GROchet/GROchet_PCB/TopViewAnotated.png

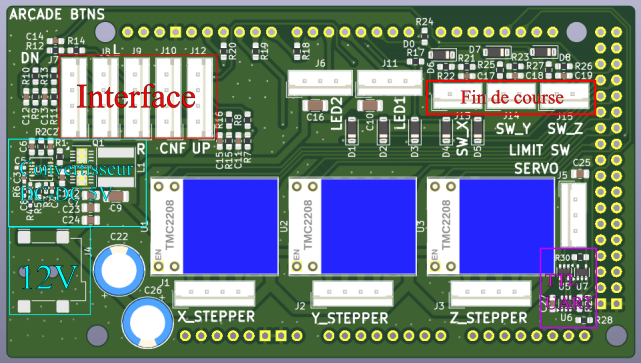
TopViewAnotated.png
