GROchet/GROchet_PCB/GROchet_Bloc_Diagram.drawio.png

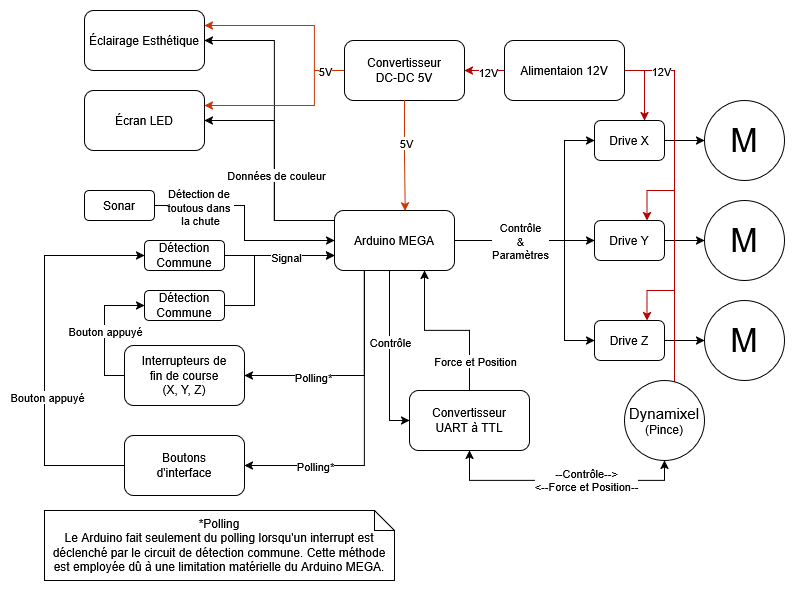
GROchet_Bloc_Diagram.drawio.png
