GROchet/GROchet_PCB/WBSchematicTPS40305DRCR.png

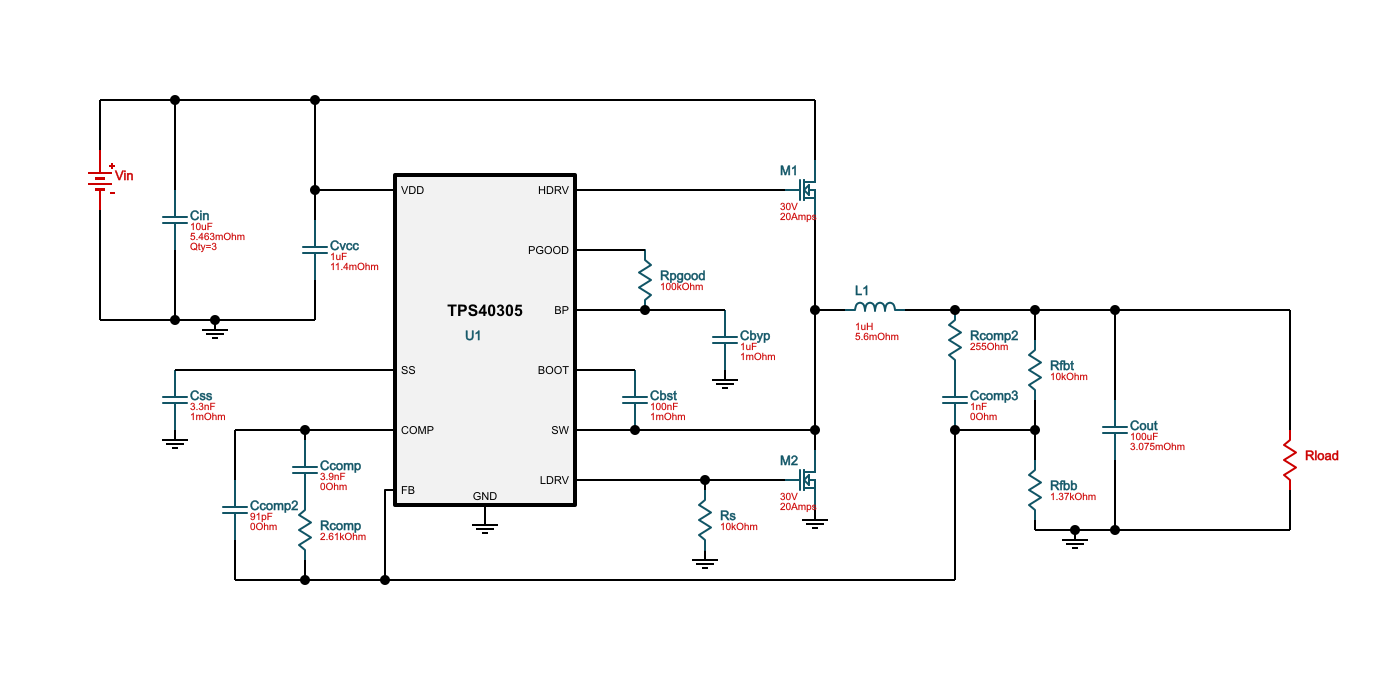
WBSchematicTPS40305DRCR.png
