GROchet/GROchet_PCB/LTSpice/Button_Debounce.asc

C1: cap; 1µ
R1: res; 10000
R2: res; 1000
V1: voltage; 5
Named nets: 0
.ic N002 = 5
