GROchet/GROchet_PCB/GROchet_PCB.kicad_pcb

## KiCad design GROchet_PCB.kicad_pcb (2026-02-21)

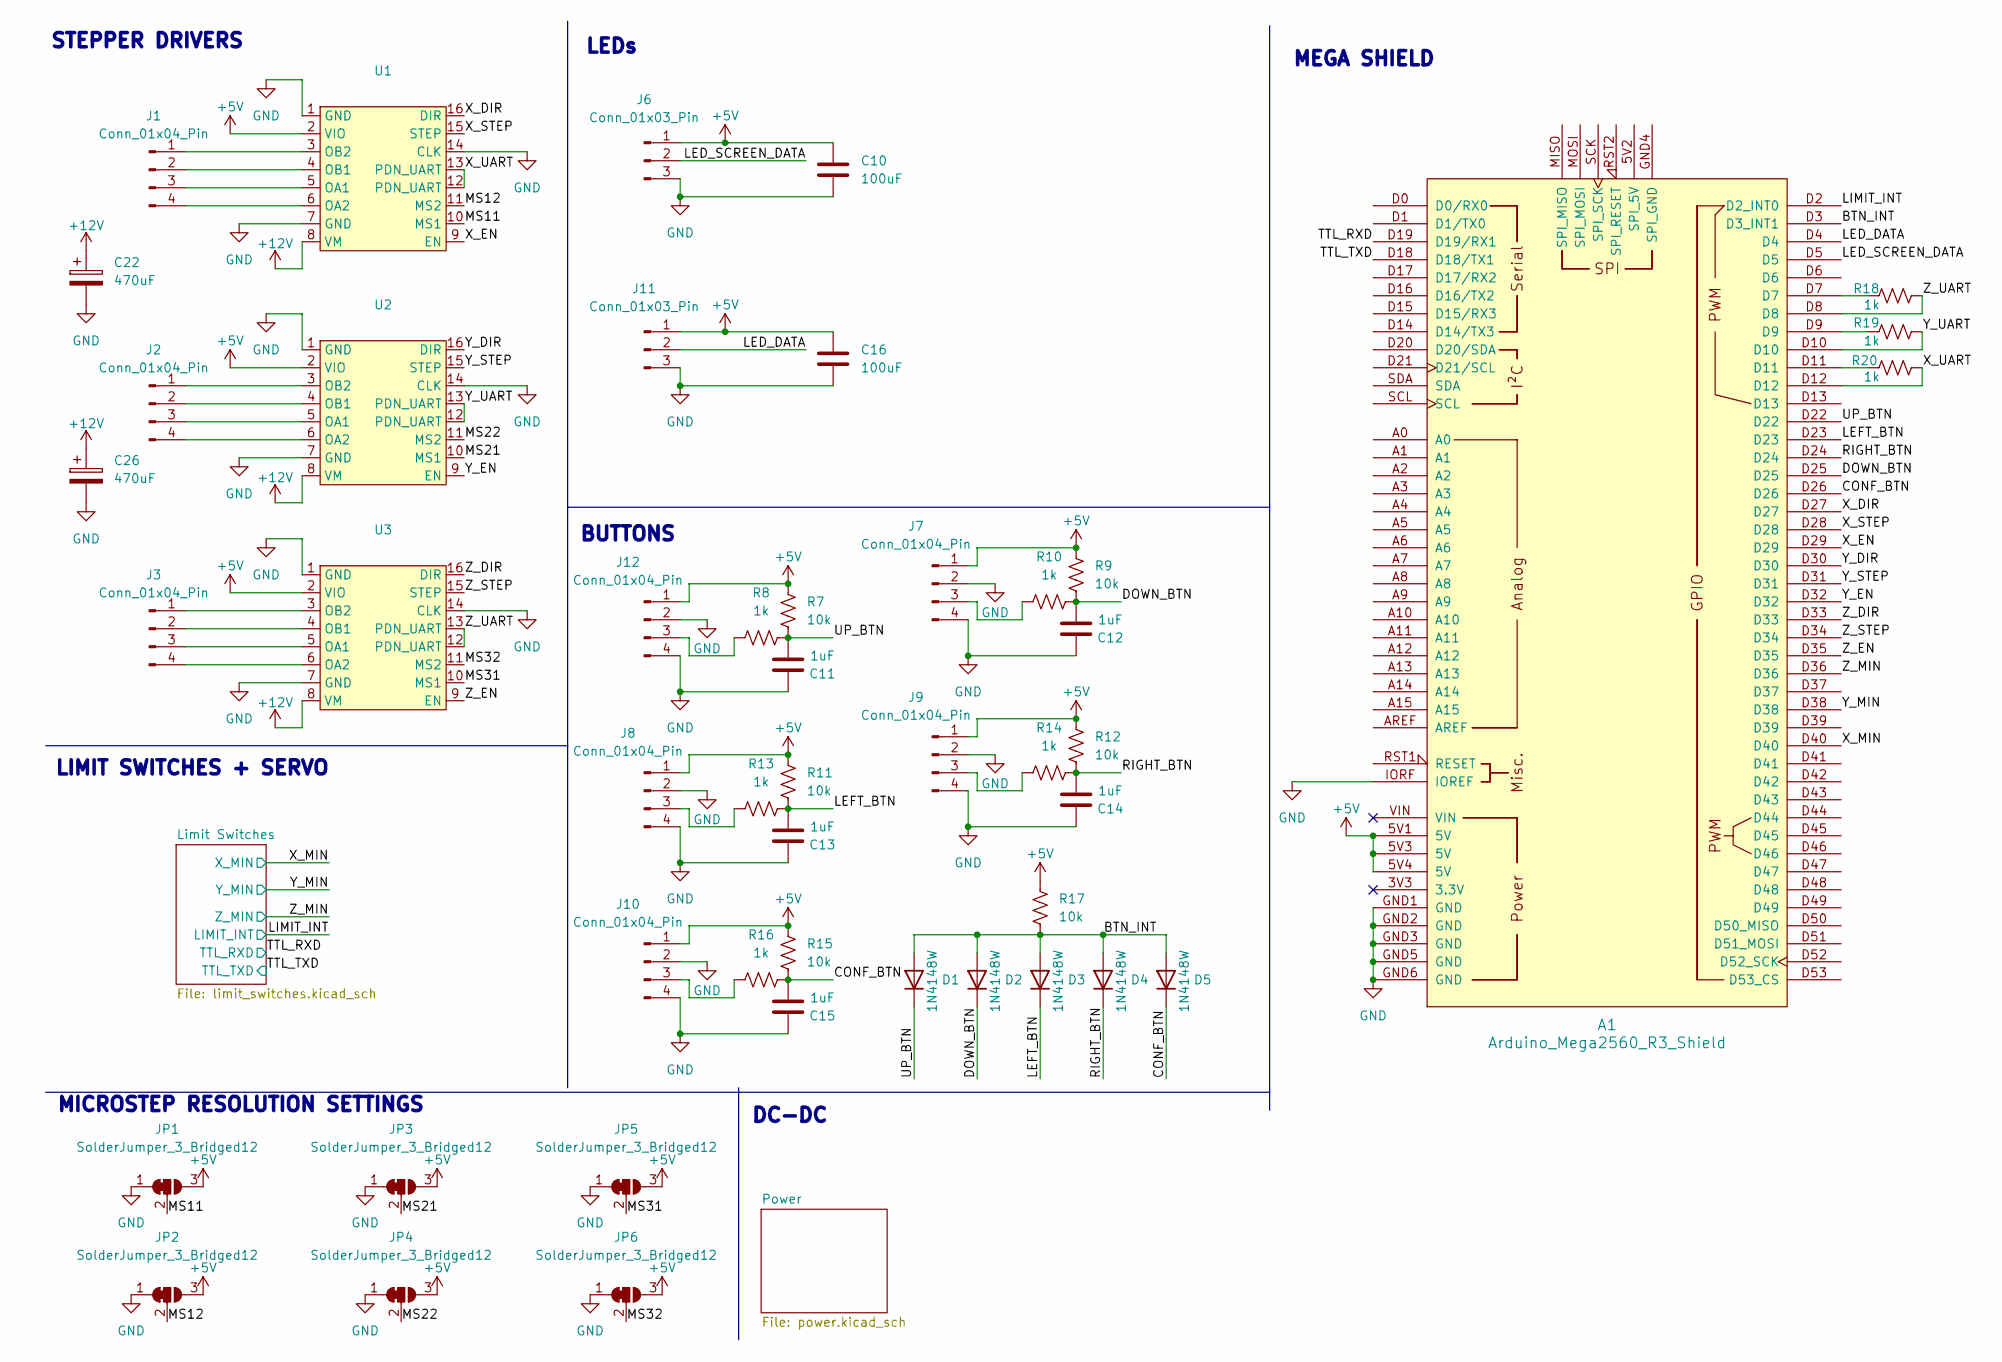
[picture p7: schematic GROchet_PCB.kicad_sch]

Parts:
A1: Arduino_Mega2560_R3_Shield
C10, C16: 100uF; C_1206_3216Metric; LCSC C7432784
C11, C12, C13, C14, C15: 1uF; C_0603_1608Metric_Pad1.08x0.95mm_HandSolder
C22, C26: 470uF; CP_Radial_D8.0mm_P3.50mm; LCSC C2873977
D1, D2, D3, D4, D5: 1N4148W; D_SOD-123; LCSC C83528
J1, J2, J3, J7, J8, J9, J10, J12: Conn_01x04_Pin; JST_EH_B4B-EH-A_1x04_P2.50mm_Vertical; LCSC C160258
J6, J11: Conn_01x03_Pin; JST_EH_B3B-EH-A_1x03_P2.50mm_Vertical; LCSC C144394
JP1, JP2, JP3, JP4, JP5, JP6: SolderJumper_3_Bridged12; SolderJumper-3_P1.3mm_Bridged12_RoundedPad1.0x1.5mm
R7, R9, R11, R12, R15, R17: 10k; R_0603_1608Metric_Pad0.98x0.95mm_HandSolder; LCSC C98220
R8, R10, R13, R14, R16, R18, R19, R20: 1k; R_0603_1608Metric_Pad0.98x0.95mm_HandSolder; LCSC C2907113
U1, U2, U3: TMC2208

Connections:
+5V: A1.5V1 (5V), A1.5V3 (5V), A1.5V4 (5V), C10.1, C16.1, J6.1, J7.1, J8.1, J9.1, J10.1, J11.1, J12.1, JP1.3 (B), JP2.3 (B), JP3.3 (B), JP4.3 (B), JP5.3 (B), JP6.3 (B), R7.1, R9.1, R11.1, R12.1, R15.1, R17.1, U1.2 (VIO), U2.2 (VIO), U3.2 (VIO); also elsewhere on the board
+12V: C22.1, C26.1, U1.8 (VM), U2.8 (VM), U3.8 (VM); also elsewhere on the board
/BTN_INT: A1.D3 (D3_INT1), D1.2 (A), D2.2 (A), D3.2 (A), D4.2 (A), D5.2 (A), R17.2
/CONF_BTN: A1.D26, C15.2, D5.1 (K), R15.2, R16.2
/DOWN_BTN: A1.D25, C12.2, D2.1 (K), R9.2, R10.2
/LED_DATA: A1.D4, J11.2
/LED_SCREEN_DATA: A1.D5, J6.2
/LEFT_BTN: A1.D23, C13.2, D3.1 (K), R11.2, R13.2
/LIMIT_INT: A1.D2 (D2_INT0); also elsewhere on the board
/MS11: JP1.2 (C), U1.10 (MS1)
/MS12: JP2.2 (C), U1.11 (MS2)
/MS21: JP3.2 (C), U2.10 (MS1)
/MS22: JP4.2 (C), U2.11 (MS2)
/MS31: JP5.2 (C), U3.10 (MS1)
/MS32: JP6.2 (C), U3.11 (MS2)
/RIGHT_BTN: A1.D24, C14.2, D4.1 (K), R12.2, R14.2
/TTL_RXD: A1.D19 (D19/RX1); also elsewhere on the board
/TTL_TXD: A1.D18 (D18/TX1); also elsewhere on the board
/UP_BTN: A1.D22, C11.2, D1.1 (K), R7.2, R8.2
/X_DIR: A1.D27, U1.16 (DIR)
/X_EN: A1.D29, U1.9 (EN)
/X_MIN: A1.D40; also elsewhere on the board
/X_STEP: A1.D28, U1.15 (STEP)
/X_UART: A1.D12, R20.2, U1.12 (PDN_UART), U1.13 (PDN_UART)
/Y_DIR: A1.D30, U2.16 (DIR)
/Y_EN: A1.D32, U2.9 (EN)
/Y_MIN: A1.D38; also elsewhere on the board
/Y_STEP: A1.D31, U2.15 (STEP)
/Y_UART: A1.D10, R19.2, U2.12 (PDN_UART), U2.13 (PDN_UART)
/Z_DIR: A1.D33, U3.16 (DIR)
/Z_EN: A1.D35, U3.9 (EN)
/Z_MIN: A1.D36; also elsewhere on the board
/Z_STEP: A1.D34, U3.15 (STEP)
/Z_UART: A1.D8, R18.2, U3.12 (PDN_UART), U3.13 (PDN_UART)
GND: A1.GND1 (GND), A1.GND2 (GND), A1.GND3 (GND), A1.GND5 (GND), A1.GND6 (GND), A1.IORF (IOREF), C10.2, C11.1, C12.1, C13.1, C14.1, C15.1, C16.2, C22.2, C26.2, J6.3, J7.2, J7.4, J8.2, J8.4, J9.2, J9.4, J10.2, J10.4, J11.3, J12.2, J12.4, JP1.1 (A), JP2.1 (A), JP3.1 (A), JP4.1 (A), JP5.1 (A), JP6.1 (A), U1.1 (GND), U1.7 (GND), U1.14 (CLK), U2.1 (GND), U2.7 (GND), U2.14 (CLK), U3.1 (GND), U3.7 (GND), U3.14 (CLK); also elsewhere on the board
unnamed: A1.D7, R18.1
unnamed: A1.D9, R19.1
unnamed: A1.D11, R20.1
unnamed: J1.1, U1.3 (OB2)
unnamed: J1.2, U1.4 (OB1)
unnamed: J1.3, U1.5 (OA1)
unnamed: J1.4, U1.6 (OA2)
unnamed: J2.1, U2.3 (OB2)
unnamed: J2.2, U2.4 (OB1)
unnamed: J2.3, U2.5 (OA1)
unnamed: J2.4, U2.6 (OA2)
unnamed: J3.1, U3.3 (OB2)
unnamed: J3.2, U3.4 (OB1)
unnamed: J3.3, U3.5 (OA1)
unnamed: J3.4, U3.6 (OA2)
unnamed: J7.3, R10.1
unnamed: J8.3, R13.1
unnamed: J9.3, R14.1
unnamed: J10.3, R16.1
unnamed: J12.3, R8.1

Notes on the sheet:
LEDs
BUTTONS
STEPPER DRIVERS
LIMIT SWITCHES + SERVO
MICROSTEP RESOLUTION SETTINGS
DC-DC
MEGA SHIELD

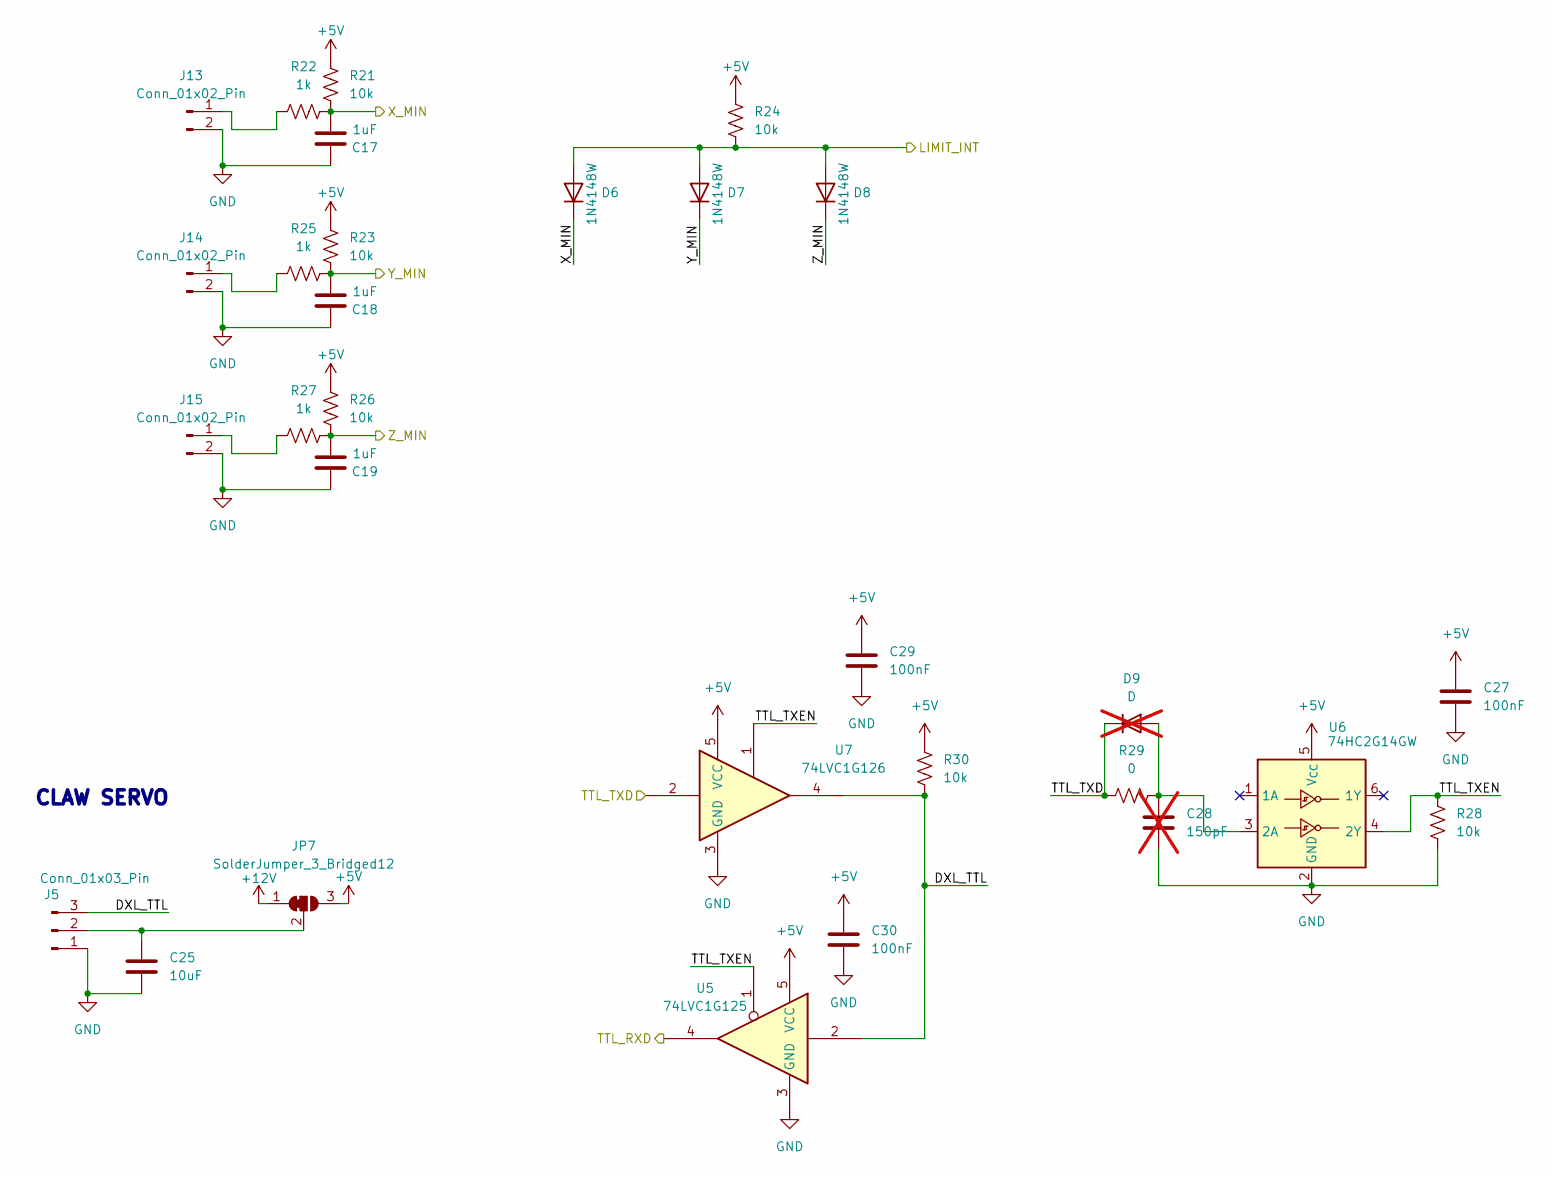
[picture p8: schematic limit_switches.kicad_sch]

Parts:
C17, C18, C19: 1uF; C_0603_1608Metric_Pad1.08x0.95mm_HandSolder
C25: 10uF; C_0805_2012Metric; LCSC C6119932
C27, C29, C30: 100nF; C_0603_1608Metric_Pad1.08x0.95mm_HandSolder
C28: 150pF; C_0603_1608Metric_Pad1.08x0.95mm_HandSolder; not fitted
D6, D7, D8: 1N4148W; D_SOD-123; LCSC C83528
D9: D; D_SOD-123; not fitted
J5: Conn_01x03_Pin; JST_EH_B3B-EH-A_1x03_P2.50mm_Vertical; LCSC C144394
J13, J14, J15: Conn_01x02_Pin; JST_EH_B2B-EH-A_1x02_P2.50mm_Vertical; LCSC C265281
JP7: SolderJumper_3_Bridged12; SolderJumper-3_P1.3mm_Bridged12_RoundedPad1.0x1.5mm
R21, R23, R24, R26, R28, R30: 10k; R_0603_1608Metric_Pad0.98x0.95mm_HandSolder; LCSC C98220
R22, R25, R27: 1k; R_0603_1608Metric_Pad0.98x0.95mm_HandSolder; LCSC C2907113
R29: 0; R_0603_1608Metric_Pad0.98x0.95mm_HandSolder
U5: 74LVC1G125; SOT-353_SC-70-5
U6: 74HC2G14GW; SOT-363_SC-70-6
U7: 74LVC1G126; SOT-353_SC-70-5

Connections:
+5V: C27.1, C29.1, C30.1, JP7.3 (B), R21.1, R23.1, R24.1, R26.1, R30.1, U5.5 (VCC), U6.5 (V_{CC}), U7.5 (VCC); also elsewhere on the board
+12V: JP7.1 (A); also elsewhere on the board
/LIMIT_INT: D6.2 (A), D7.2 (A), D8.2 (A), R24.2; also elsewhere on the board
/Limit Switches/DXL_TTL: J5.3, R30.2, U5.2, U7.4
/Limit Switches/TTL_TXEN: R28.1, U5.1, U6.4 (2Y), U7.1
/TTL_RXD: U5.4; also elsewhere on the board
/TTL_TXD: D9.1 (K), R29.1, U7.2; also elsewhere on the board
/X_MIN: C17.2, D6.1 (K), R21.2, R22.2; also elsewhere on the board
/Y_MIN: C18.2, D7.1 (K), R23.2, R25.2; also elsewhere on the board
/Z_MIN: C19.2, D8.1 (K), R26.2, R27.2; also elsewhere on the board
GND: C17.1, C18.1, C19.1, C25.2, C27.2, C28.2, C29.2, C30.2, J5.1, J13.2, J14.2, J15.2, R28.2, U5.3 (GND), U6.2 (GND), U7.3 (GND); also elsewhere on the board
unnamed: C28.1, D9.2 (A), R29.2, U6.3 (2A)
unnamed: C25.1, J5.2, JP7.2 (C)
unnamed: J13.1, R22.1
unnamed: J14.1, R25.1
unnamed: J15.1, R27.1

Notes on the sheet:
CLAW SERVO

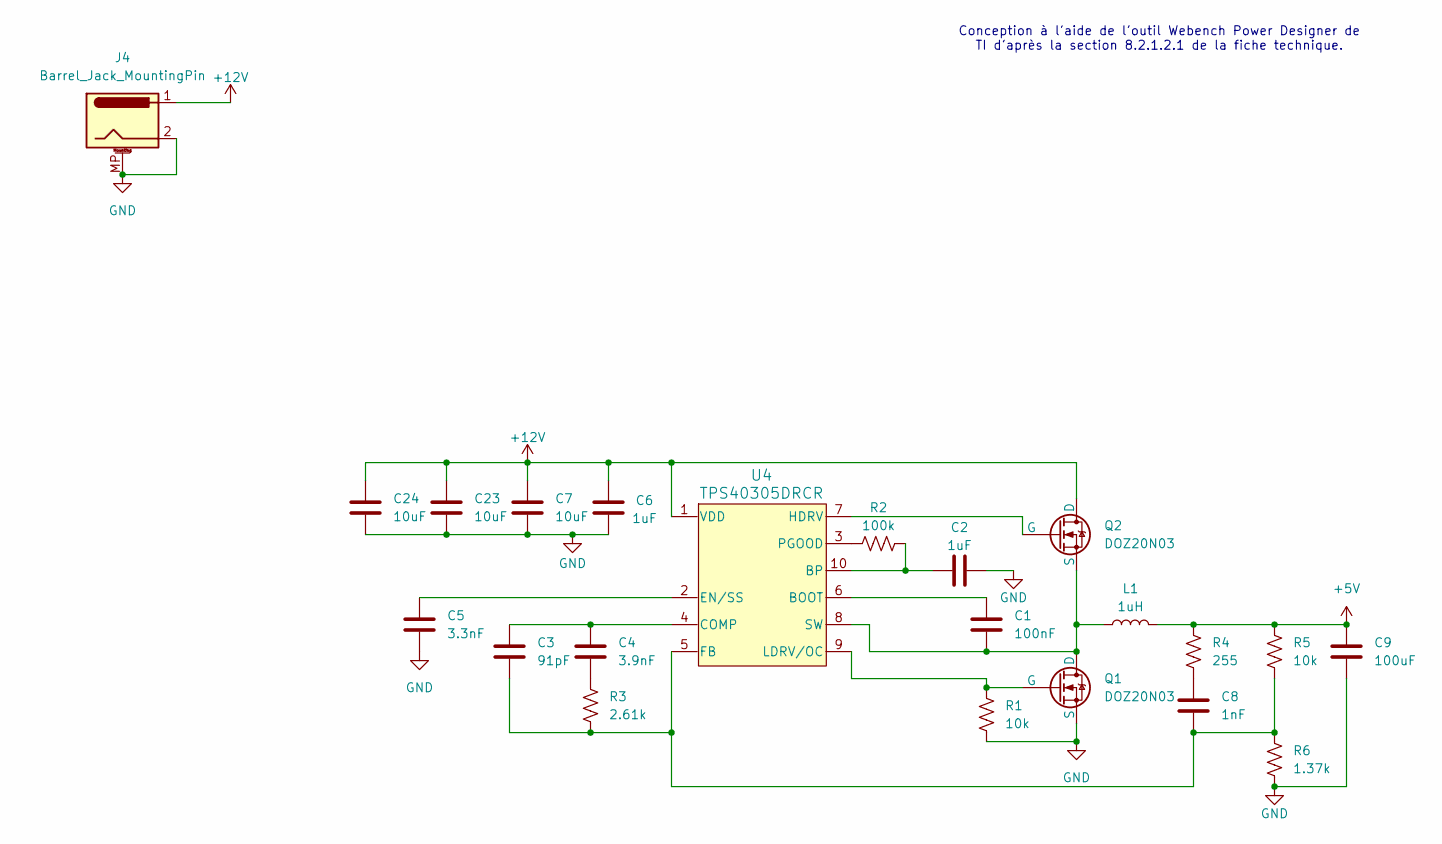
[picture p9: schematic power.kicad_sch]

Parts:
C1: 100nF; C_0603_1608Metric_Pad1.08x0.95mm_HandSolder
C2, C6: 1uF; C_0603_1608Metric_Pad1.08x0.95mm_HandSolder
C3: 91pF; C_0402_1005Metric_Pad0.74x0.62mm_HandSolder; LCSC C541365
C4: 3.9nF; C_0402_1005Metric_Pad0.74x0.62mm_HandSolder; LCSC C880632
C5: 3.3nF; C_0402_1005Metric_Pad0.74x0.62mm_HandSolder; LCSC C7503512
C7, C23, C24: 10uF; C_0805_2012Metric; LCSC C6119932
C8: 1nF; C_0402_1005Metric_Pad0.74x0.62mm_HandSolder; LCSC C22435950
C9: 100uF; C_1206_3216Metric; LCSC C7432784
J4: Barrel_Jack_MountingPin; BarrelJack_Wuerth_694108106102_2.5x5.5mm
L1: 1uH; L_Taiyo-Yuden_NR-60xx; LCSC C2938919
Q1, Q2: DOZ20N03; DFN-8-1EP_3x3mm_P0.5mm_EP1.7x2.4mm_ThermalVias; LCSC C41384259
R1, R5: 10k; R_0603_1608Metric_Pad0.98x0.95mm_HandSolder; LCSC C98220
R2: 100k; R_0603_1608Metric_Pad0.98x0.95mm_HandSolder; LCSC C14675
R3: 2.61k; R_0402_1005Metric_Pad0.72x0.64mm_HandSolder; LCSC C60491
R4: 255; R_0402_1005Metric_Pad0.72x0.64mm_HandSolder; LCSC C48533742
R6: 1.37k; R_0402_1005Metric_Pad0.72x0.64mm_HandSolder; LCSC C5126218
U4: TPS40305DRCR; DRC10_2P4X1P65; LCSC C140285

Connections:
+5V: C9.1, L1.2, R4.1, R5.1; also elsewhere on the board
+12V: C6.2, C7.1, C23.1, C24.1, J4.1, Q2.1 (D), U4.1 (VDD); also elsewhere on the board
GND: C2.2, C5.2, C6.1, C7.2, C9.2, C23.2, C24.2, J4.2, J4.MP (MountPin), Q1.3 (S), R1.2, R6.2; also elsewhere on the board
unnamed: C4.2, R3.1
unnamed: C8.1, R4.2
unnamed: C1.2, L1.1, Q1.1 (D), Q2.3 (S), U4.8 (SW)
unnamed: Q1.2 (G), R1.1, U4.9 (LDRV/OC)
unnamed: Q2.2 (G), U4.7 (HDRV)
unnamed: C1.1, U4.6 (BOOT)
unnamed: C2.1, R2.2, U4.10 (BP)
unnamed: C3.1, C4.1, U4.4 (COMP)
unnamed: C5.1, U4.2 (EN/SS)
unnamed: C3.2, C8.2, R3.2, R5.2, R6.1, U4.5 (FB)
unnamed: R2.1, U4.3 (PGOOD)

Notes on the sheet:
Conception à l'aide de l'outil Webench Power Designer de TI d'après la section 8.2.1.2.1 de la fiche technique.

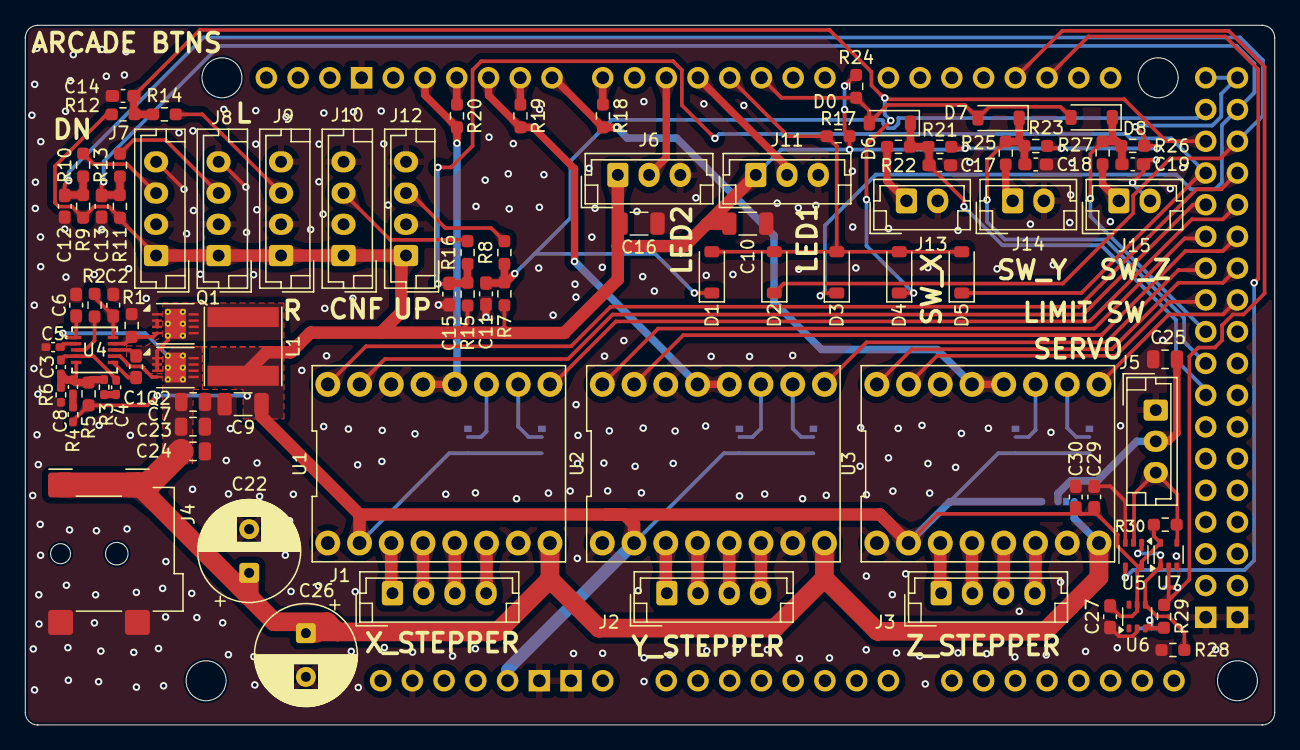
[picture p10: board GROchet_PCB.kicad_pcb from above]

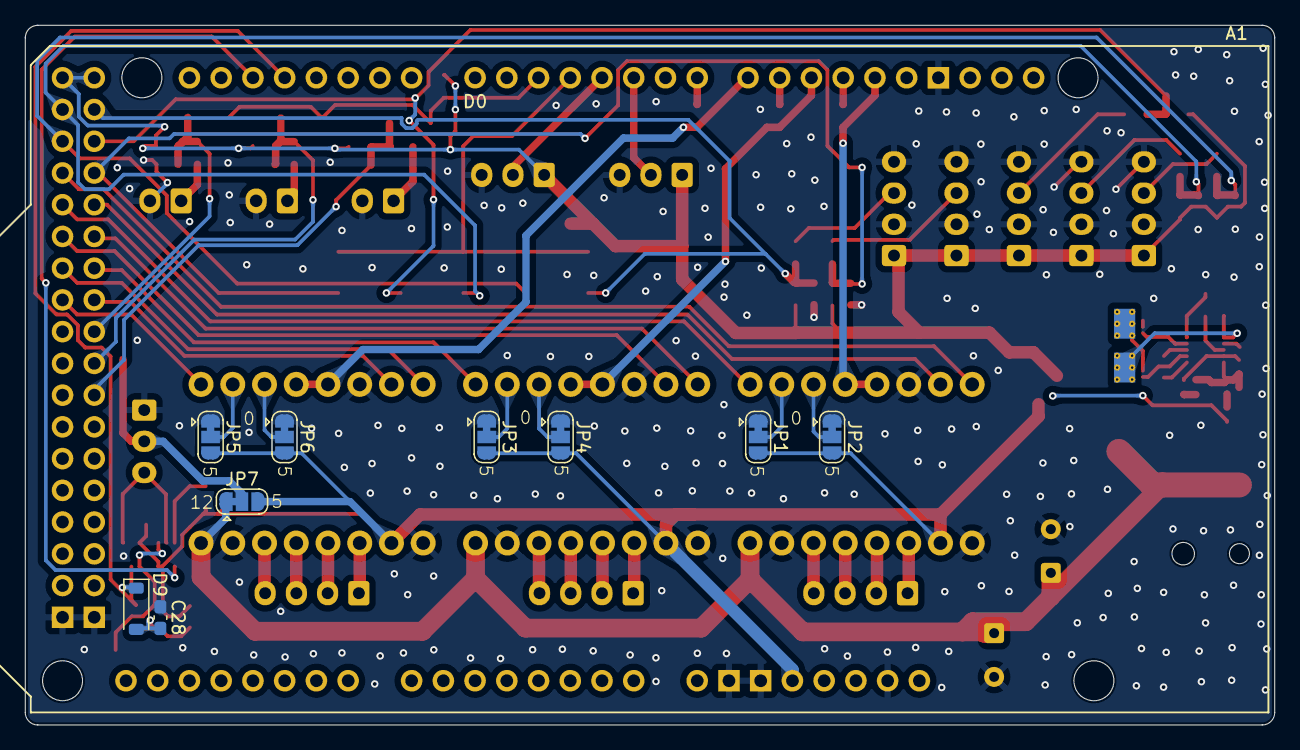
[picture p11: board GROchet_PCB.kicad_pcb from below]

Board: 2 copper layers, 100.0 x 56.0 mm, 100 parts (9 on the bottom side), 73 nets.
