GROchet/GROchet_PCB/(commit log)

2026-01-23 project setup
    [GROchet_PCB.kicad_pcb, GROchet_PCB.kicad_sch]
2026-01-27 shematic design
    [GROchet_PCB.kicad_sch, WBBOMDesignTPS40305DRCR.csv, limit_switches.kicad_sch, power.kicad_sch]
2026-01-28 started pcb layout
    [GROchet_PCB.kicad_pcb, GROchet_PCB.kicad_sch, power.kicad_sch]
2026-02-03 finished routing
    [GROchet_PCB.kicad_pcb, GROchet_PCB.kicad_sch, limit_switches.kicad_sch]
2026-02-04 DXL Buffer circuit and new prod file
    [GROchet_PCB.kicad_pcb, GROchet_PCB.kicad_sch, limit_switches.kicad_sch]
2026-02-21 added html bom
    [GROchet_PCB.kicad_pcb, GROchet_PCB.kicad_sch, limit_switches.kicad_sch, power.kicad_sch]
2026-02-24 updated schematic pdf
